daharoni/wire-free-miniscope/wire-free CMOS PCB/Miniscope_Untetheredv1_PCB_Fab_Info.docx

Miniscope Untethered v1 Circuit Board Fabrication Information

- Number of layers: 6
  - Top Layer (GTL)
  - Power Plane (GP1)
  - Mid Layer 1 (G1)
  - Mid Layer 2 (G2)
  - Power Plane (GP2)
  - Bottom Layer (GBL)
- Substrate: 0.031” FR4 (No strict layer stack dimensions/properties)
- Board width: 17mm
- Board height: 19mm
- Board outline: Mechanical layer 4 (GM4)
- Minimum trace: 5mil
- Minimum clearance: 5mil
- Minimum via: 6mil
- Via in pad: Yes
- Filled vias: Yes (Non-conductive)
- Copper weight: 1oz
- Surface: ENIG
- Board shape: Custom
- Cutouts: None
- Solder mask color: Black
- Sinkscreen layers: Top and Bottom
- Sinkscreen color: White
