daharoni/wire-free-miniscope/wire-free CMOS PCB/StackReport.xls

Board Stack Report
Stack Up |  | Layer Stack
Layer | Board Layer Stack | Name | Material | Thickness | Constant
1 |  | Top Paste
2 |  | Top Overlay
3 |  | Top Solder | Solder Resist
4 |  | Component Side | Copper
5 |  | Dielectric 1 | FR-4
6 |  | Ground Plane (GND) | Copper
7 |  | Dielectric 3
8 |  | Inner Layer 1 | Copper
9 |  | Dielectric 6
10 |  | Inner Layer 2 | Copper
11 |  | Dielectric 5
12 |  | Power Plane (VCC) | Copper
13 |  | Dielectric 4
14 |  | Solder Side | Copper
15 |  | Bottom Solder | Solder Resist
16 |  | Bottom Overlay
17 |  | Bottom Paste
