daharoni/wire-free-miniscope/MiniscopeSDCardReader/MiniscopeSDCardReader/ReadMe.txt

================================================================================
    MICROSOFT FOUNDATION CLASS LIBRARY : MiniscopeSDCardReader Project Overview
===============================================================================

The application wizard has created this MiniscopeSDCardReader application for
you.  This application not only demonstrates the basics of using the Microsoft
Foundation Classes but is also a starting point for writing your application.

This file contains a summary of what you will find in each of the files that
make up your MiniscopeSDCardReader application.

MiniscopeSDCardReader.vcxproj
    This is the main project file for VC++ projects generated using an application wizard.
    It contains information about the version of Visual C++ that generated the file, and
    information about the platforms, configurations, and project features selected with the
    application wizard.

MiniscopeSDCardReader.vcxproj.filters
    This is the filters file for VC++ projects generated using an Application Wizard. 
    It contains information about the assciation between the files in your project 
    and the filters. This association is used in the IDE to show grouping of files with
    similar extensions under a specific node (for e.g. ".cpp" files are associated with the
    "Source Files" filter).

MiniscopeSDCardReader.h
    This is the main header file for the application.  It includes other
    project specific headers (including Resource.h) and declares the
    CMiniscopeSDCardReaderApp application class.

MiniscopeSDCardReader.cpp
    This is the main application source file that contains the application
    class CMiniscopeSDCardReaderApp.

MiniscopeSDCardReader.rc
    This is a listing of all of the Microsoft Windows resources that the
    program uses.  It includes the icons, bitmaps, and cursors that are stored
    in the RES subdirectory.  This file can be directly edited in Microsoft
    Visual C++. Your project resources are in 1033.

res\MiniscopeSDCardReader.ico
    This is an icon file, which is used as the application's icon.  This
    icon is included by the main resource file MiniscopeSDCardReader.rc.

res\MiniscopeSDCardReader.rc2
    This file contains resources that are not edited by Microsoft
    Visual C++. You should place all resources not editable by
    the resource editor in this file.

/////////////////////////////////////////////////////////////////////////////

The application wizard creates one dialog class:

MiniscopeSDCardReaderDlg.h, MiniscopeSDCardReaderDlg.cpp - the dialog
    These files contain your CMiniscopeSDCardReaderDlg class.  This class defines
    the behavior of your application's main dialog.  The dialog's template is
    in MiniscopeSDCardReader.rc, which can be edited in Microsoft Visual C++.

/////////////////////////////////////////////////////////////////////////////

Help Support:

hlp\MiniscopeSDCardReader.hhp
    This file is a help project file. It contains the data needed to
    compile the help files into a .chm file.

hlp\MiniscopeSDCardReader.hhc
    This file lists the contents of the help project.

hlp\MiniscopeSDCardReader.hhk
    This file contains an index of the help topics.

hlp\afxcore.htm
    This file contains the standard help topics for standard MFC
    commands and screen objects. Add your own help topics to this file.

hlp\afxprint.htm
    This file contains the help topics for the printing commands.

makehtmlhelp.bat
    This file is used by the build system to compile the help files.

hlp\Images\*.gif
    These are bitmap files required by the standard help file topics for
    Microsoft Foundation Class Library standard commands.

/////////////////////////////////////////////////////////////////////////////

Other Features:

ActiveX Controls
    The application includes support to use ActiveX controls.

Printing and Print Preview support
    The application wizard has generated code to handle the print, print setup, and print preview
    commands by calling member functions in the CView class from the MFC library.

/////////////////////////////////////////////////////////////////////////////

Other standard files:

StdAfx.h, StdAfx.cpp
    These files are used to build a precompiled header (PCH) file
    named MiniscopeSDCardReader.pch and a precompiled types file named StdAfx.obj.

Resource.h
    This is the standard header file, which defines new resource IDs.
    Microsoft Visual C++ reads and updates this file.

MiniscopeSDCardReader.manifest
	Application manifest files are used by Windows XP to describe an applications
	dependency on specific versions of Side-by-Side assemblies. The loader uses this
	information to load the appropriate assembly from the assembly cache or private
	from the application. The Application manifest  maybe included for redistribution
	as an external .manifest file that is installed in the same folder as the application
	executable or it may be included in the executable in the form of a resource.
/////////////////////////////////////////////////////////////////////////////

Other notes:

The application wizard uses "TODO:" to indicate parts of the source code you
should add to or customize.

If your application uses MFC in a shared DLL, you will need
to redistribute the MFC DLLs. If your application is in a language
other than the operating system's locale, you will also have to
redistribute the corresponding localized resources MFC100XXX.DLL.
For more information on both of these topics, please see the section on
redistributing Visual C++ applications in MSDN documentation.

/////////////////////////////////////////////////////////////////////////////
