daharoni/wire-free-miniscope/wire-free focus slider/MS_FocusSlidervWireless.png

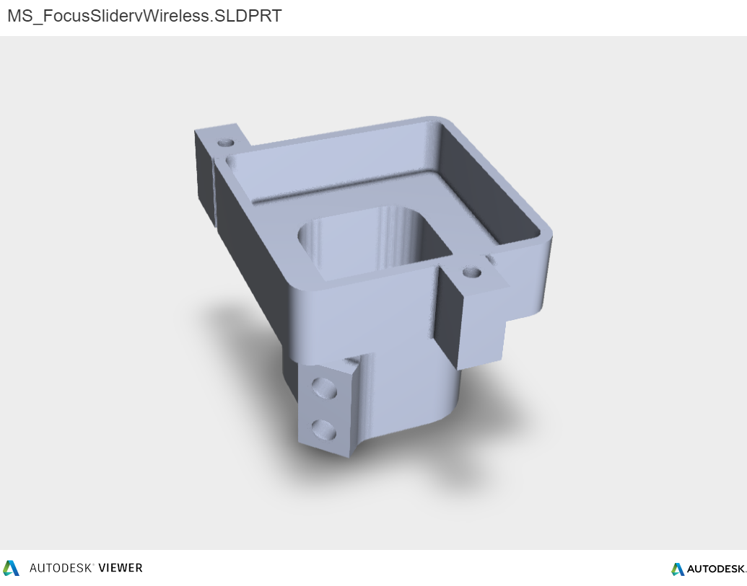
wire-free focus slider/MS_FocusSlidervWireless.png
