daharoni/wire-free-miniscope/wire-free CMOS PCB/Miniscope_Untetheredv1_BOM.xlsx

Comment | Description | Designator | Footprint | LibRef | Manufacturer Part Number | Quantity | Value
Murata GRM155R71C104KA88D | 0402 0.1 uF 16V ±10 % Tolerance X7R SMT Multilayer Ceramic Capacitor | C1, C3, C5, C7, C8, C9, C12, C13, C14, C16, C17, C28, C29, C30 | CAPC1005X55X25LL05T10 | CMP-d4951d9cf0e30b52-12 | GRM155R71C104KA88D | 14
Samsung CL05A106MP5NUNC | CL05 Series 0402 10 uF 10 V ±20 % X5R SMT Multilayer Ceramic Capacitor | C2, C4, C6, C21, C22, C23 | PCB-f7r9madups15q2flo6b5-1 | CMP-0e48c614871dd18f-2 | CL05A106MP5NUNC | 6
Murata GRM155R70J105KA12D | Cap Ceramic 1uF 6.3V X7R 10% SMD 0402 125C Paper T/R | C15, C27 | CAPC1005X55X25LL05T10 | CMP-9133121-2 | GRM155R70J105KA12D | 2
Murata GRM155R60J475ME47D | CAP CER 4.7UF 6.3V 20% X5R 0402 | C18, C25 | CAPC1005X55X25LL05T10 | CMP-4106127-2 | GRM155R60J475ME47D | 2
Murata GRM1555C1H120JA01D | Multilayer Ceramic Capacitors MLCC - SMD/SMT 0402 12pF 50volts C0G 5% | C19, C20 | CAPC1005X55X25LL05T10 | CMP-2265473-2 | GRM1555C1H120JA01D | 2
Murata GRM155R60J225ME95D | Murata 2.2F 20% 6.3 V dc X5R Dielectric SMD Ceramic Multilayer Capacitor 0402 | C24 | CAPC1005X55X25LL05T10 | CMP-2511417-2 | GRM155R60J225ME95D | 1
Murata GRM155R60J225ME95D | Murata 2.2F 20% 6.3 V dc X5R Dielectric SMD Ceramic Multilayer Capacitor 0402 | C26 | CAPC1005X55X25NL05T10 | CMP-2511417-2 | GRM155R60J225ME95D | 1
Vishay / Lite-On LTST-C191KRKT | LED SUPER RED CLR THIN 0603 SMD | D1 | LED1608x55L | CMP-1544848-3 | LTST-C191KRKT | 1
Vishay TSOP57438TT1 | IR Receivers / SMD PH.MODULE 38KHZ T.VIEW-e3 | D2 | PCB-rxignohmhwwbcdr49pvh-1 | CMP-62e5aa93536cbd22-4 | TSOP57438TT1 | 1
Molex 0475710001 | Conn Micro Sd Card Push-Pull r/a | J1 | PCB-gwct26a1sfovcgvkigvj-1 | CMP-423b8a3e94869dfc-1 | 0475710001 | 1
Murata BLM18PG471SN1D | BLM18P Series 0603 470 O 1000 mA 0.2 O DCR EMIFIL Inductor Chip Ferrite Bead | L1, L2, L3, L4 | PCB-38x7zorla5a68e0t6zul-1 | CMP-0686-00587-8 | BLM18PG471SN1D | 4
Murata LQM2MPN2R2MG0L | Inductor Power Chip Shielded Multi-Layer 2.2uH 20% 1MHz Ferrite 1.2A 138mOhm DCR 0806 T/R | L5, L6 | 0806 SMD Inductor | CMP-cd41053c13371286-1 | LQM2MPN2R2MG0L | 2 | 2.2uH
NTK3134NT1G | Power MOSFET, 20 V, 890 mA, Single N-Channel with ESD Protection, 3-Pin SOT-723, Pb-Free, Tape and Reel | Q1 | ONSC-SOT-723-3-631AA-01_V | CMP-836783-2 | NTK3134NT1G | 1
Panasonic ERJ-2RKF4871X | Thick Film Resistors - SMD 0402 4.87Kohms 1% Tol | R1 | RESC1005X40X25NL05T05 | CMP-3652827-2 | ERJ-2RKF4871X | 1
Panasonic ERJ-2RKF4990X | Thick Film Resistors - SMD 0402 499ohms 1% Tol | R2 | RESC1005X40X25NL05T05 | CMP-3652246-2 | ERJ-2RKF4990X | 1
Panasonic / Panasonic ECG ERJ-2RKF1003X | Resistor Thick Film 0402 100k Ohm 1% 1-10 Watt ±100ppm °C Surface Mount Punched Carrier Tape and Reel | R3, R4 | RESC1005X40X25NL10T10 | CMP-3656264-6 | ERJ-2RKF1003X | 2
Panasonic ERJ-2RKF1001X | Res Thick Film 0402 1K Ohm 1% 0.1W(1/10W) ±100ppm/C Molded SMD Automotive Punched T/R | R5, R6 | RESC1005X40X25NL05T05 | CMP-1846973-2 | ERJ-2RKF1001X | 2
Panasonic ERJ-2RKF2001X | Thick Film Resistors - SMD 0402 2Kohms 1% Tol | R7 | RESC1005X40X25NL05T05 | CMP-3656523-2 | ERJ-2RKF2001X | 1
Panasonic ERJ-2RKF8251X | Thick Film Resistors - SMD 0402 8.25Kohms 1% Tol | R8 | RESC1005X40X25NL05T05 | CMP-3651372-2 | ERJ-2RKF8251X | 1
E2V JADE EV76C454 | 0.5 Mpixel Digital 1/2.9" CMOS Image Sensor | U1 | uCLCC48 | CMP-i46hgbls1lpmknvhdyhs-4 | EV76C454 | 1
Atmel ATSAME70N21A-CN | MCU 32-bit SAM E70 ARM Cortex M7 RISC 2048KB Flash 1.8V/2.5V/3.3V 100-Pin TFBGA Tray | U2 | PCB-riz48565jdh61v0tc6cm-1 | CMP-a38e69f228637c49-2 | ATSAME70N21A-CN | 1
LTC3407EDD-3#PBF | Dual Synchronous 800 mA, 2.25 MHz Step-Down DC/DC Regulator, 10-pin SON (DD-10), -40 to 85 degC, Pb-Free | U3 | LT-DD-10_V | CMP-1486900-2 | LTC3407EDD-3#PBF | 1
LTC3218EDDB#PBF | 400 mA Single Wire Camera LED Charge Pump, 2.9 to 4.5 V Vin, 5.3 V Vout MAX, 10-pin SON (DDB-10), -40 to 85 degC, Pb-Free | U4 | LT-DDB-10_V | CMP-2937550-2 | LTC3218EDDB#PBF | 1
Texas Instruments TXS0206AYFPR | TXS0206A MMC, SD Card, Memory Stick(TM) Voltage-Translation Transceiver 20-DSBGA -40 to 85 | U5 | TXS0206A | CMP-fa0a32531cc125cd-2 | TXS0206AYFPR | 1
ABM8G-12.000MHZ-4Y-T3 | Crystal 12MHz Â±30ppm (Tol) Â±30ppm (Stability) 10pF FUND 120Ohm 4-Pin Mini-CSMD T/R | Y1 | PCB-4sepxroiskk6o67y4qoj-1 | CMP-d84310797dcd0784-1 | ABM8G-12.000MHZ-4Y-T3 | 1
