daharoni/wire-free-miniscope/wire-free focus slider/MS_FocusSlidervWireless.SLDPRT

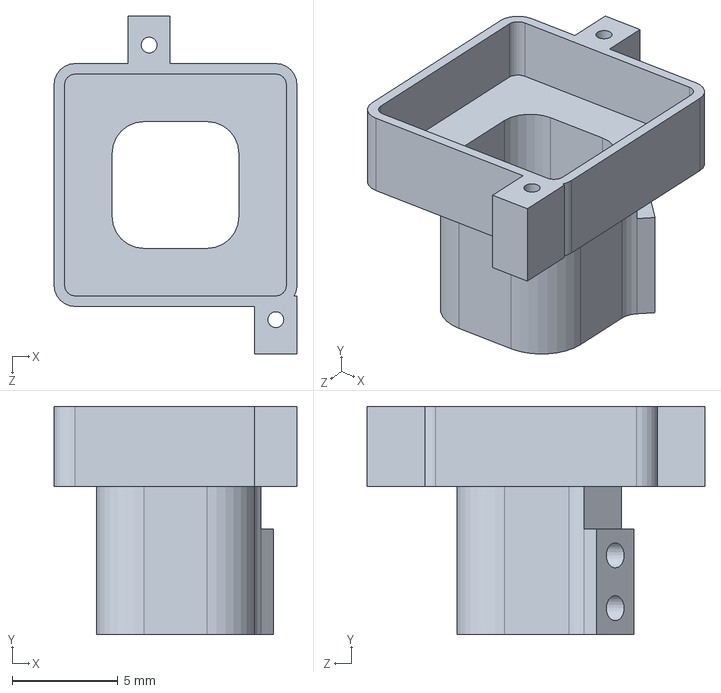
[picture p14: CAD file, 2019-05-21]
wire-free focus slider/MS_FocusSlidervWireless.SLDPRT
11.5 x 10.8 x 16.0 mm
