daharoni/wire-free-miniscope/wire-free CMOS PCB/Miniscope_Untetheredv1.PDF

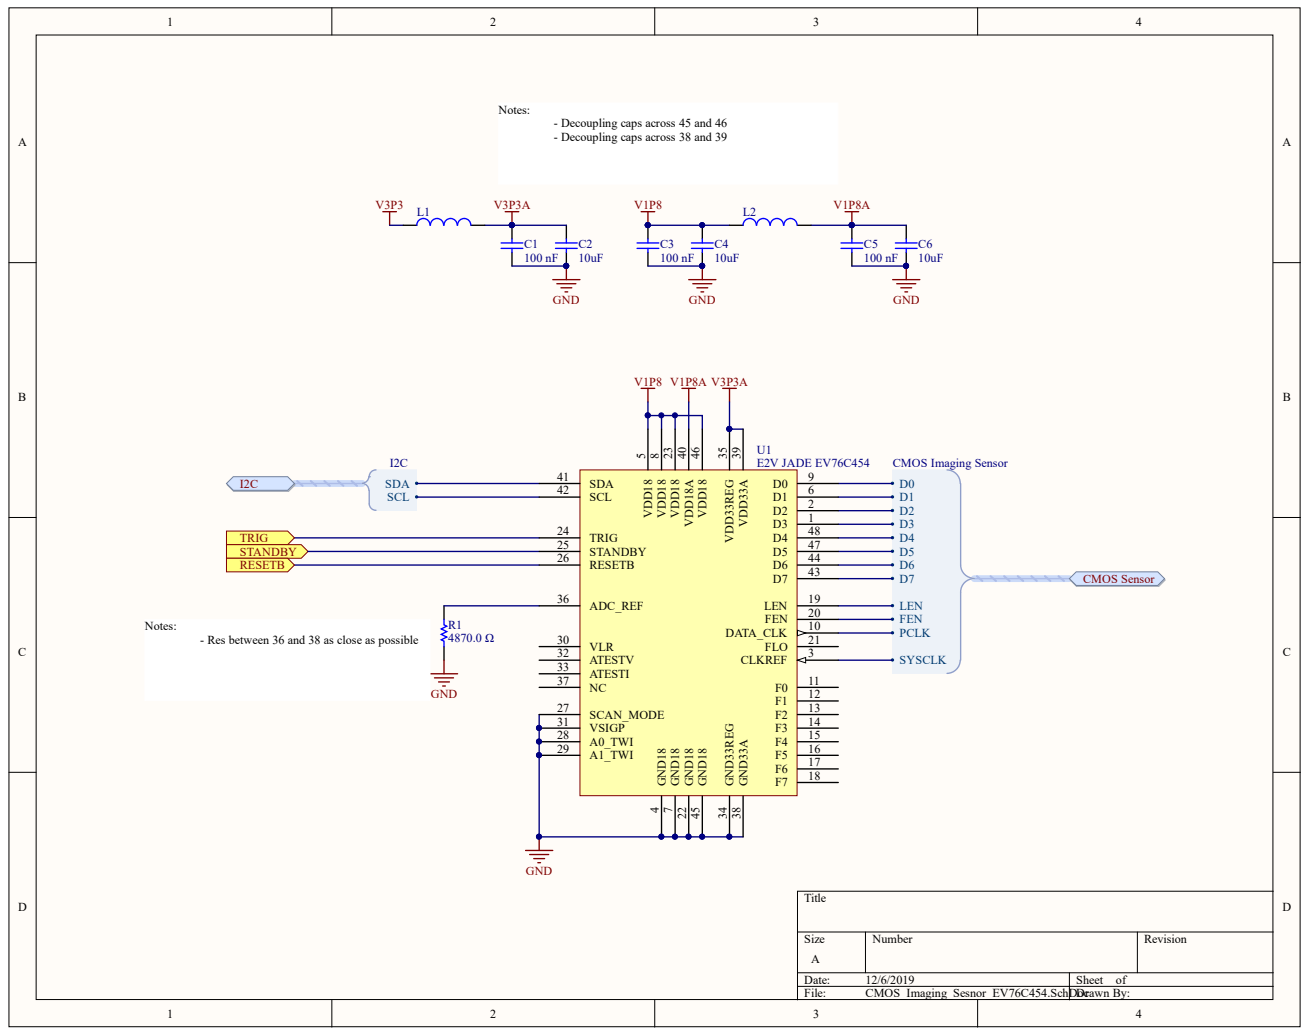
[picture p15: page 1]

- Decoupling caps across 45 and 46
- Decoupling caps across 38 and 39

- Res between 36 and 38 as close as possible

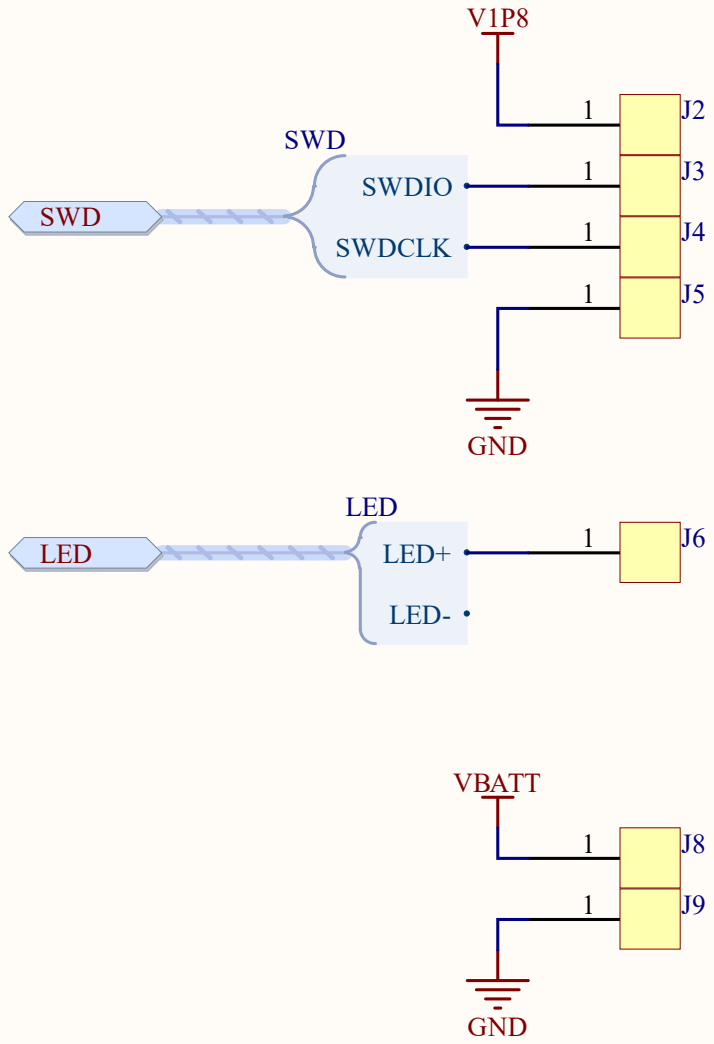
[picture p16: page 2]
File:; Connectors.SchDoc; Drawn By:; J6 LED+; POSWDOSWD0SWDCLK POSWD0SWDIO

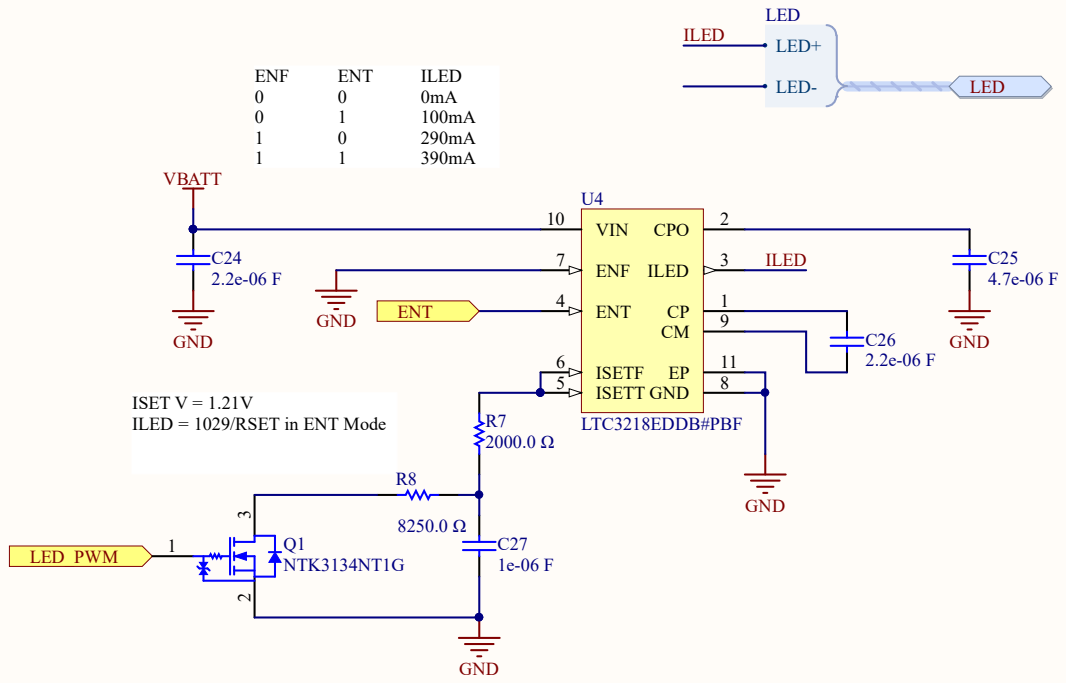
[picture p17: page 3]

ISET V = 1.21V
ILED = 1029/RSET in ENT Mode

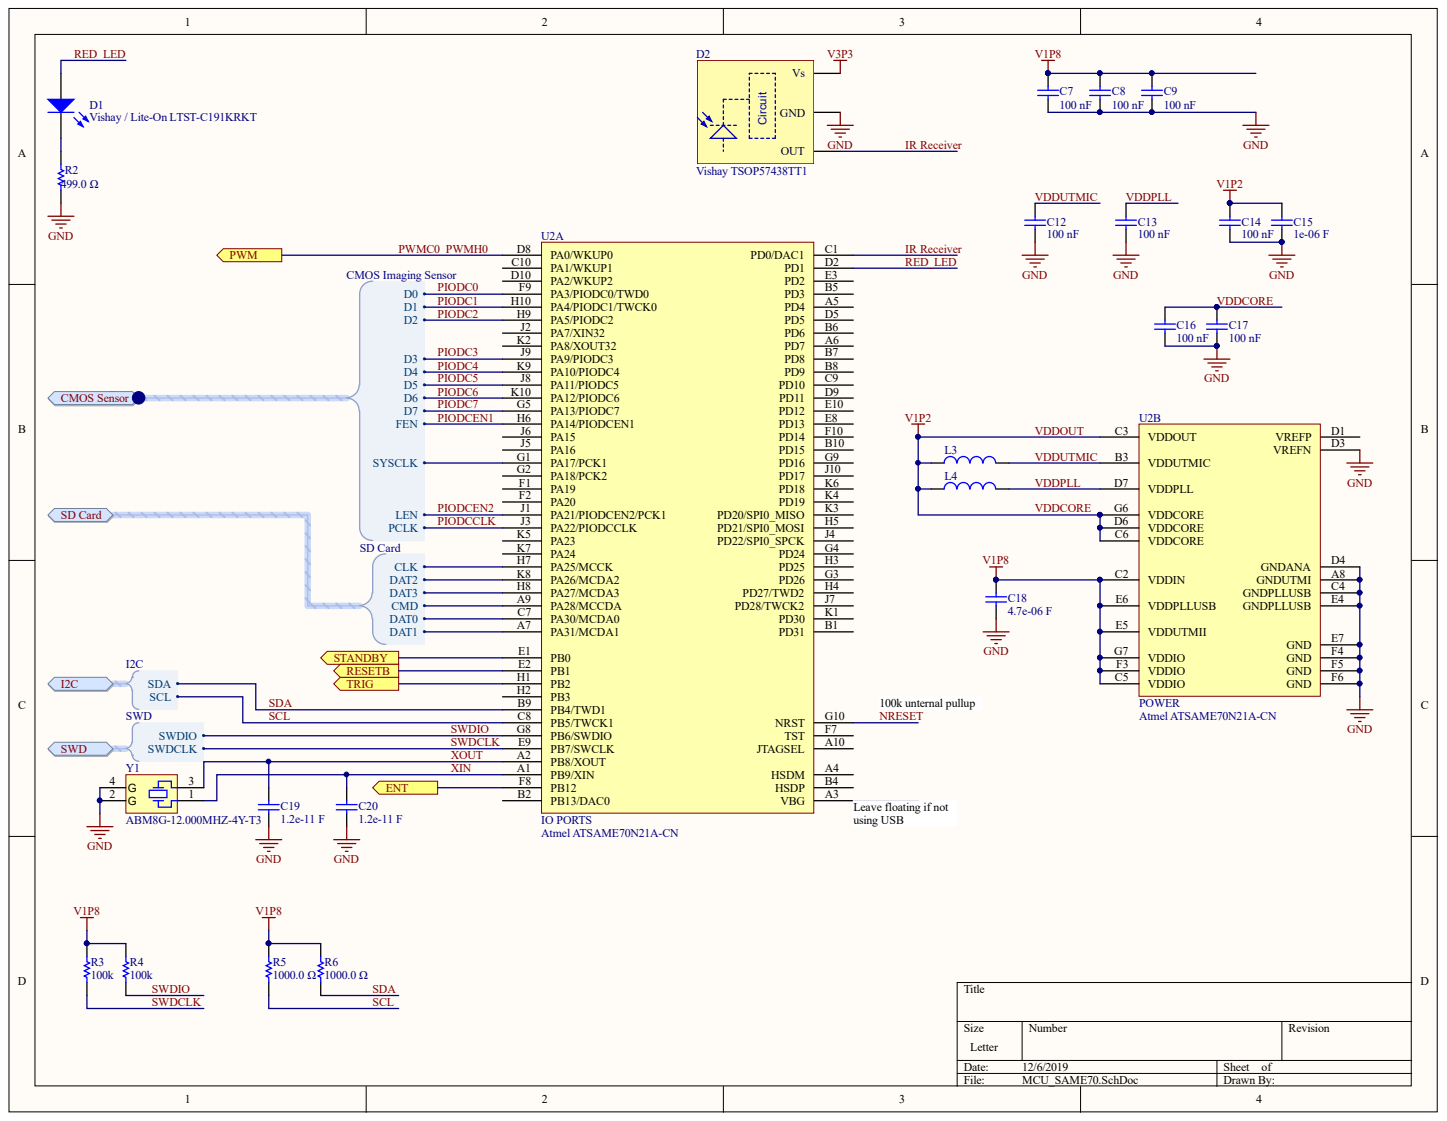
[picture p18: page 4]

Vishay / Lite-On LTST-C191KRKT

SCL | PB5/TWCK1 C8

PB8/XOUT A2

XIN | PB9/XIN A1

Leave floating if not
using USB

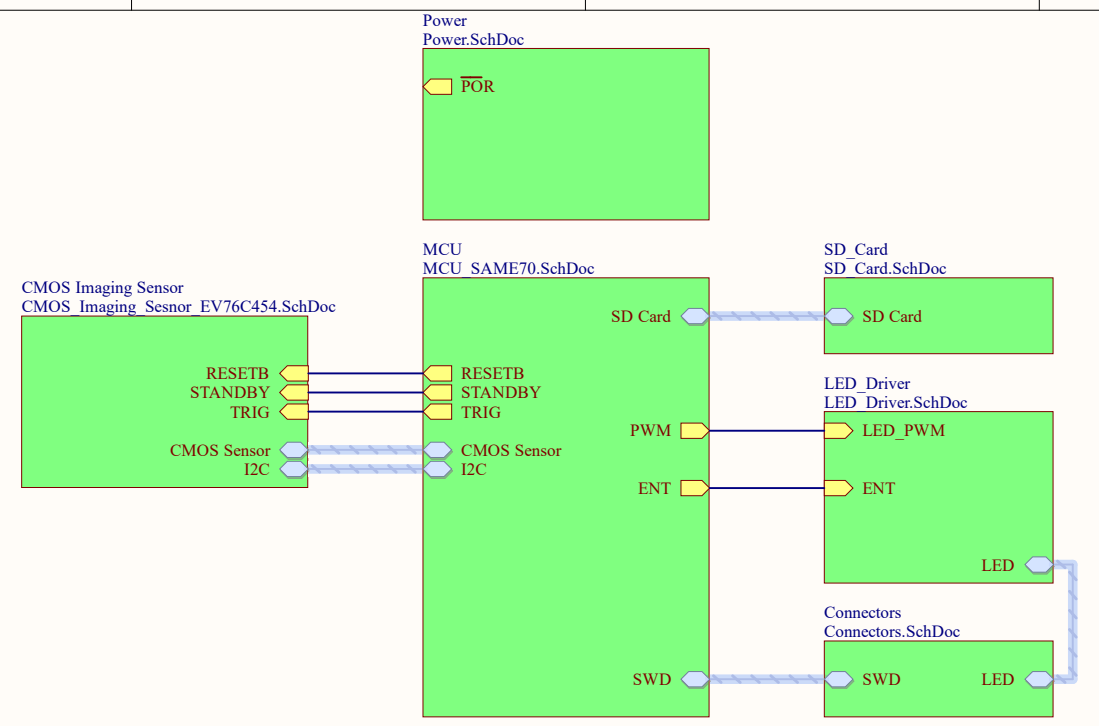
[picture p19: page 5]
File:; Miniscope_Untetheredv1.SchDoc; Drawn By:; CMOS Sensor; SD Card

CMOS Imaging Sensor
CMOS_Imaging_Sesnor_EV76C454.SchDoc

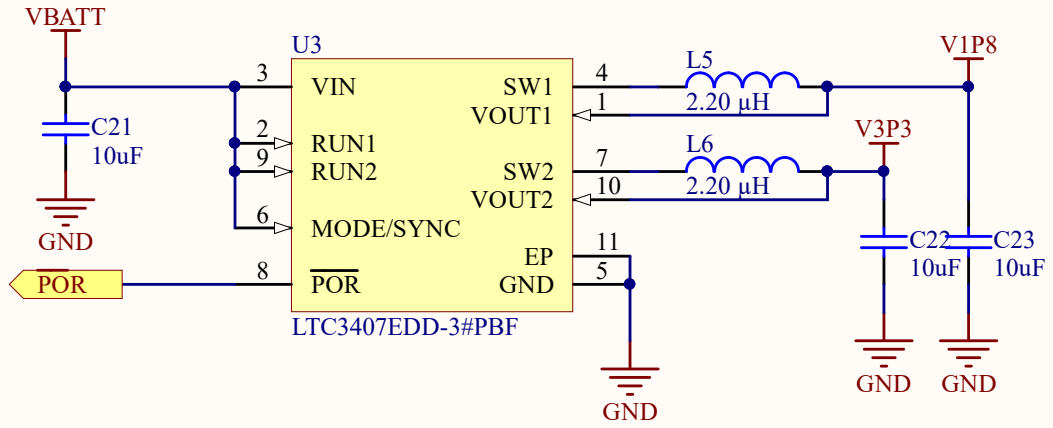
[picture p20: page 6]

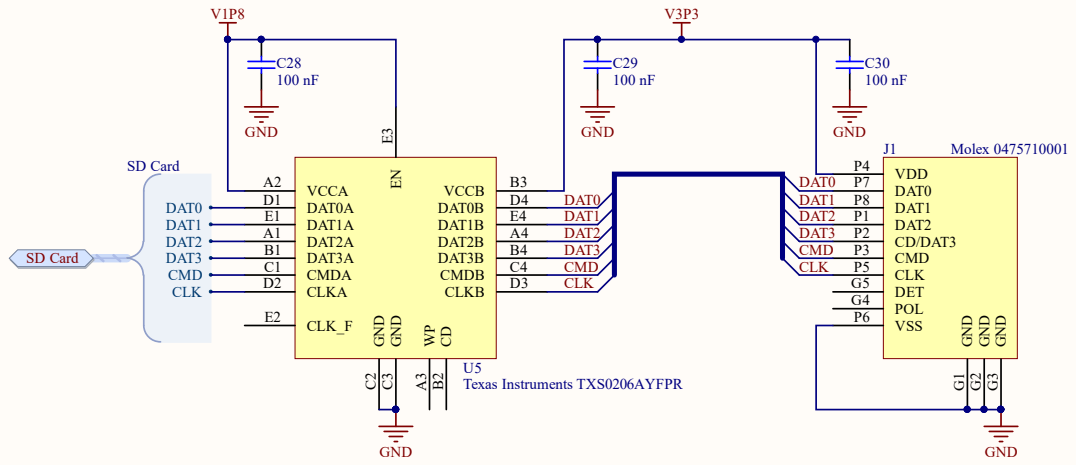
[picture p21: page 7]
CD B2 VCCB B3 DAT3B B4; GND C2; GND C3; s Ins; GND G1; GND G2; GND G3; D Card

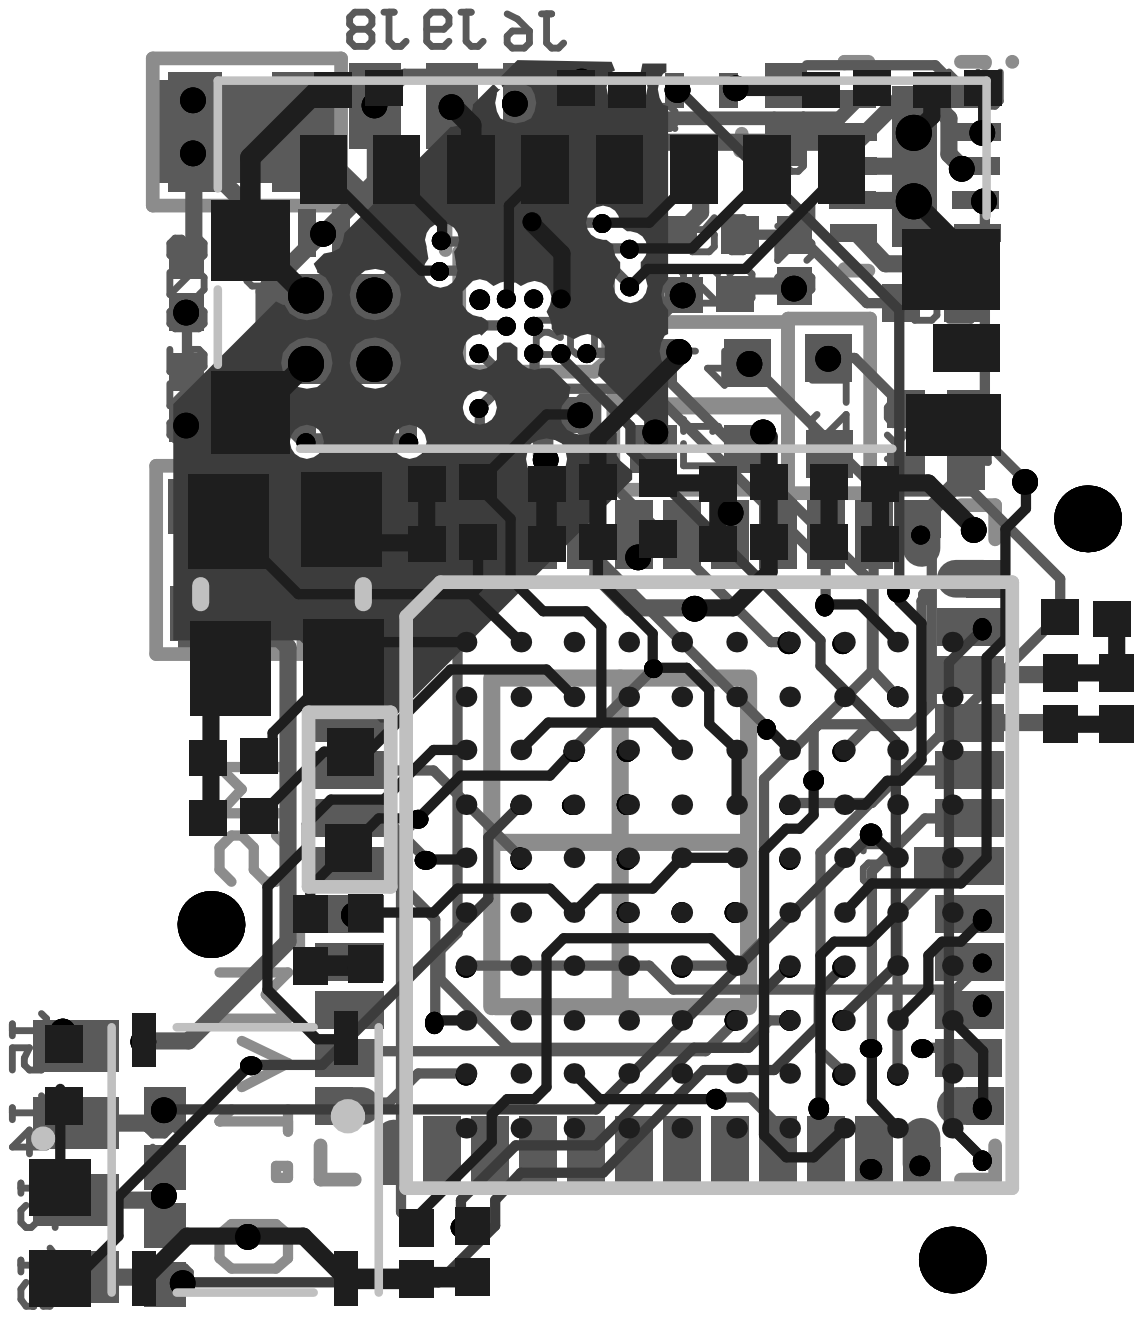
[picture p22: page 8]

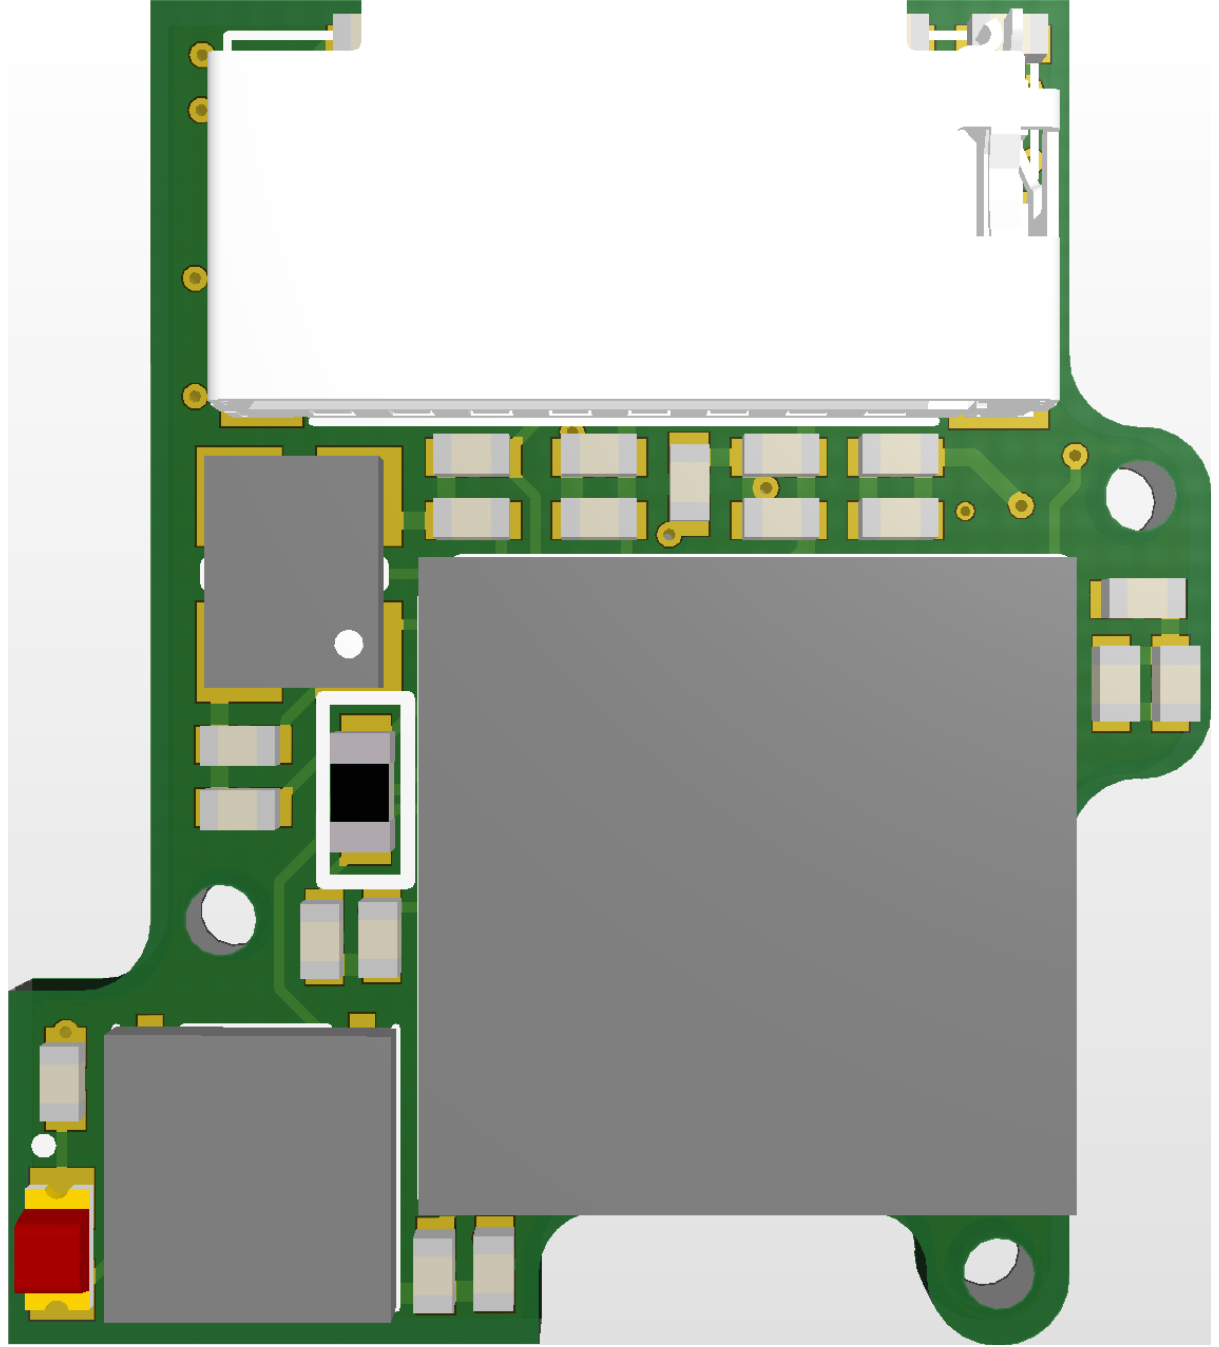
[picture p23: page 9]
