daharoni/wire-free-miniscope/Atmel/MiniscopeUntethered/MiniscopeUntethered/src/ASF/common/boards/user_board/user_board.h

/**
 * \file
 *
 * \brief User board definition template
 *
 */

 /* This file is intended to contain definitions and configuration details for
 * features and devices that are available on the board, e.g., frequency and
 * startup time for an external crystal, external memory devices, LED and USART
 * pins.
 */
/*
 * Support and FAQ: visit <a href="http://www.atmel.com/design-support/">Atmel Support</a>
 */

#ifndef USER_BOARD_H
#define USER_BOARD_H

#include <conf_board.h>

// External oscillator settings.
// Uncomment and set correct values if external oscillator is used.

// External oscillator frequency
#define BOARD_XOSC_HZ          12000000

// External oscillator type.
//!< External clock signal
//#define BOARD_XOSC_TYPE        XOSC_TYPE_EXTERNAL
//!< 32.768 kHz resonator on TOSC
//#define BOARD_XOSC_TYPE        XOSC_TYPE_32KHZ
//!< 0.4 to 16 MHz resonator on XTALS
#define BOARD_XOSC_TYPE        XOSC_TYPE_XTAL

// External oscillator startup time
#define BOARD_XOSC_STARTUP_US  500000

#  define BOARD_FREQ_SLCK_XTAL      (32768UL)
#  define BOARD_FREQ_SLCK_BYPASS    (32768UL) //shouldnt be used
#  define BOARD_FREQ_MAINCK_XTAL    (12000000UL)
#  define BOARD_FREQ_MAINCK_BYPASS  (12000000UL) //shouldnt be used
#  define BOARD_OSC_STARTUP_US      (15625UL)

#endif // USER_BOARD_H
