daharoni/wire-free-miniscope/Atmel/MiniscopeUntethered/MiniscopeUntethered/src/ASF/common/boards/user_board/init.c

/**
 * \file
 *
 * \brief User board initialization template
 *
 */
/*
 * Support and FAQ: visit <a href="http://www.atmel.com/design-support/">Atmel Support</a>
 */

#include <asf.h>
#include <board.h>
#include <conf_board.h>


#define ioport_set_pin_peripheral_mode(pin, mode) \
do {\
	ioport_set_pin_mode(pin, mode);\
	ioport_disable_pin(pin);\
} while (0)

void board_init(void)
{
	/* This function is meant to contain board-specific initialization code
	 * for, e.g., the I/O pins. The initialization can rely on application-
	 * specific board configuration, found in conf_board.h.
	 */
	 #ifdef CONF_BOARD_SD_MMC_HSMCI
	 /* Configure HSMCI pins */
	 ioport_set_pin_peripheral_mode(PIN_HSMCI_MCCDA_GPIO, PIN_HSMCI_MCCDA_FLAGS);
	 ioport_set_pin_peripheral_mode(PIN_HSMCI_MCCK_GPIO, PIN_HSMCI_MCCK_FLAGS);
	 ioport_set_pin_peripheral_mode(PIN_HSMCI_MCDA0_GPIO, PIN_HSMCI_MCDA0_FLAGS);
	 ioport_set_pin_peripheral_mode(PIN_HSMCI_MCDA1_GPIO, PIN_HSMCI_MCDA1_FLAGS);
	 ioport_set_pin_peripheral_mode(PIN_HSMCI_MCDA2_GPIO, PIN_HSMCI_MCDA2_FLAGS);
	 ioport_set_pin_peripheral_mode(PIN_HSMCI_MCDA3_GPIO, PIN_HSMCI_MCDA3_FLAGS);
	 //ioport_set_pin_mode(SD_MMC_0_CD_GPIO, SD_MMC_0_CD_FLAGS);
	 #endif
}
