daharoni/wire-free-miniscope/(commit log)

2019-05-21 Add all wire-free Miniscope files
    [MS_FocusSlidervWireless.SLDPRT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]
2019-12-07 Correct microSD card mount VSS GND pin connection
2019-12-07 Correct top copper layer gerber.
    VSS pad of microSD card mount was missing trace between pad and nearby via ground.
    [Miniscope_Untetheredv1.GTL]
